zrgravity/pwm-fan-control/pwm-fan-control bom.xlsx

Comment | Designator | Footprint | LCSC | Digikey | Mouser
10uF | C1,C2 | Capacitor_SMD:C_0805_2012Metric | Stock
0.1uF | C3,C4 | Capacitor_SMD:C_0603_1608Metric | Stock
WS2812B | D1 | LED_SMD:LED_WS2812B_PLCC4_5.0x5.0mm_P3.2mm | C139127
12V_IN | J1 | 0 - GIE Connectors, Terminal Blocks:conn_edge_PTH_2.54mm_2x5_02 | Wire or 0.1" male header
FAN_OUT | J2 | 0 - GIE Connectors, Terminal Blocks:conn_edge_PTH_2.54mm_2x5_04 | Wire or 0.1" male header
Conn_ESP_PROG_1.27mm_TagConnect | J3 | Connector:Tag-Connect_TC2030-IDC-NL_2x03_P1.27mm_Vertical | TagConnect - no BOM item
ADJ_IN | J4 | 0 - GIE Connectors, Terminal Blocks:conn_edge_PTH_2.54mm_2x5_03 | Wire or 0.1" male header
NMOS (100V 1.5A 2Vth) | Q1 | Package_TO_SOT_SMD:SOT-89-3 | C161844
10k | R1 | Resistor_SMD:R_0603_1608Metric | Stock
NCP1117-5.0_SOT223 | U1 | Package_TO_SOT_SMD:SOT-223-3_TabPin2 | C17314 (https://lcsc.com/product-detail/Linear-Voltage-Regulators-LDO_onsemi-NCP1117ST50T3G_C17314.html) |  | 863-NCP1117ST50T3G (http://www.mouser.com/ProductDetail/ON-Semiconductor/NCP1117ST50T3G/)
ATtiny10-TS | U2 | Package_TO_SOT_SMD:SOT-23-6 | C2649376 (https://lcsc.com/product-detail/Microcontroller-Units-MCUs-MPUs-SOCs_Microchip-Tech-ATTINY10-TS8R_C2649376.html) |  | 556-ATTINY10-TS8R
