zrgravity/pwm-fan-control/pwm-fan-control.pdf

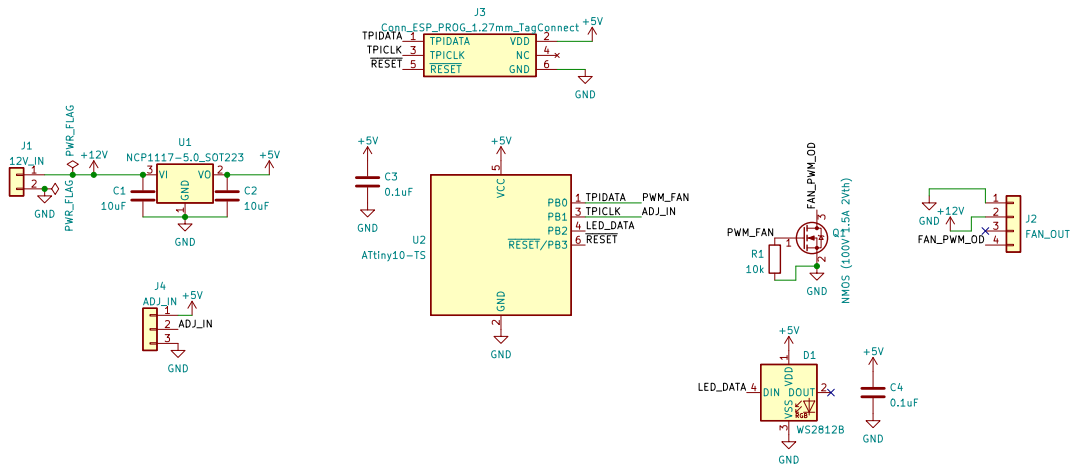
[picture p1: page 1]

File: pwm-fan-control.kicad_sch Sheet: / GIE Design

Id: 1/1 Title: PWM Fan Controller
