zrgravity/pwm-fan-control/pwm-fan-control.kicad_pcb

## KiCad design pwm-fan-control.kicad_pcb (2021-10-19)

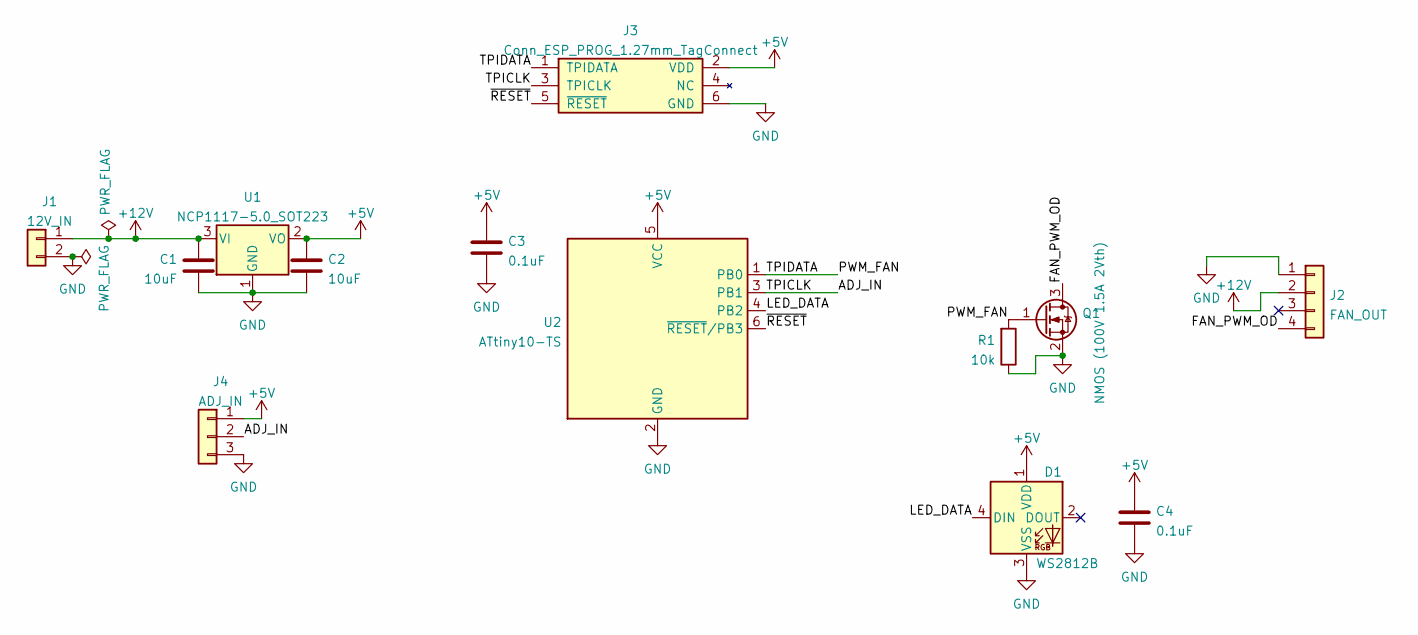
[picture p2: schematic pwm-fan-control.kicad_sch]

Parts:
C1, C2: 10uF; C_0805_2012Metric
C3, C4: 0.1uF; C_0603_1608Metric
D1: WS2812B; LED_WS2812B_PLCC4_5.0x5.0mm_P3.2mm
J1: 12V_IN; conn_edge_PTH_2.54mm_2x5_02
J2: FAN_OUT; conn_edge_PTH_2.54mm_2x5_04
J3: Conn_ESP_PROG_1.27mm_TagConnect; Tag-Connect_TC2030-IDC-NL_2x03_P1.27mm_Vertical
J4: ADJ_IN; conn_edge_PTH_2.54mm_2x5_03
Q1: NMOS (100V 1.5A 2Vth); SOT-89-3
R1: 10k; R_0603_1608Metric
U1: NCP1117-5.0_SOT223; SOT-223-3_TabPin2
U2: ATtiny10-TS; SOT-23-6

Connections:
+5V: C2.1, C3.1, C4.1, D1.1 (VDD), J3.2 (VDD), J4.1, U1.2 (VO), U2.5 (VCC)
+12V: C1.2, J1.1, J2.2, U1.3 (VI)
/FAN_PWM_OD: J2.4, Q1.3 (D)
/LED_DATA: D1.4 (DIN), U2.4 (PB2)
/TPICLK: J3.3 (TPICLK), J4.2, U2.3 (PB1)
/TPIDATA: J3.1 (TPIDATA), Q1.1 (G), R1.2, U2.1 (PB0)
/~RESET: J3.5 (~RESET), U2.6 (~RESET/PB3)
GND: C1.1, C2.2, C3.2, C4.2, D1.3 (VSS), J1.2, J2.1, J3.6 (GND), J4.3, Q1.2 (S), R1.1, U1.1 (GND), U2.2 (GND)

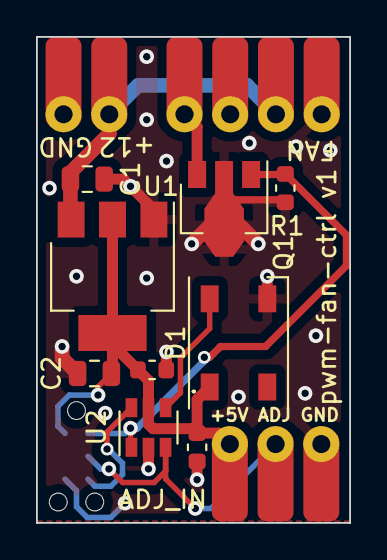
[picture p3: board pwm-fan-control.kicad_pcb from above]

Board: 2 copper layers, 17.4 x 27.0 mm, 13 parts (1 on the bottom side), 8 nets.
