zrgravity/pwm-fan-control/(commit log)

2021-10-19 Add KiCad gitignore
2021-10-19 Schematic layout done
    [pwm-fan-control.kicad_pcb, pwm-fan-control.kicad_sch]
2021-10-19 Component placement done
    [pwm-fan-control.kicad_pcb]
2021-10-19 Layout done
    [pwm-fan-control.kicad_pcb]
2021-10-19 Add BOM
    [pwm-fan-control bom.xlsx]
2021-10-19 Ignore gerber files
2021-10-19 Plot PDF schematic
    [pwm-fan-control.kicad_sch]
2021-10-19 Basic system setup and ADC reading
2021-10-19 Timer0 PWM setup
2021-11-02 Add interactive html BOM
2021-11-02 Fix main clock prescaler
    [main.c]
2021-11-02 Scale ADC value
2021-11-03 Set led green
2021-11-03 Blink green 3x on powerup
2021-11-03 Add LED fade
2021-11-03 Change PWM to 25kHz
